Syncleus/roes-hardware/rf-analyzer/rf-analyzer.kicad_pcb

## KiCad design rf-analyzer/rf-analyzer.kicad_pcb (2020-09-04)

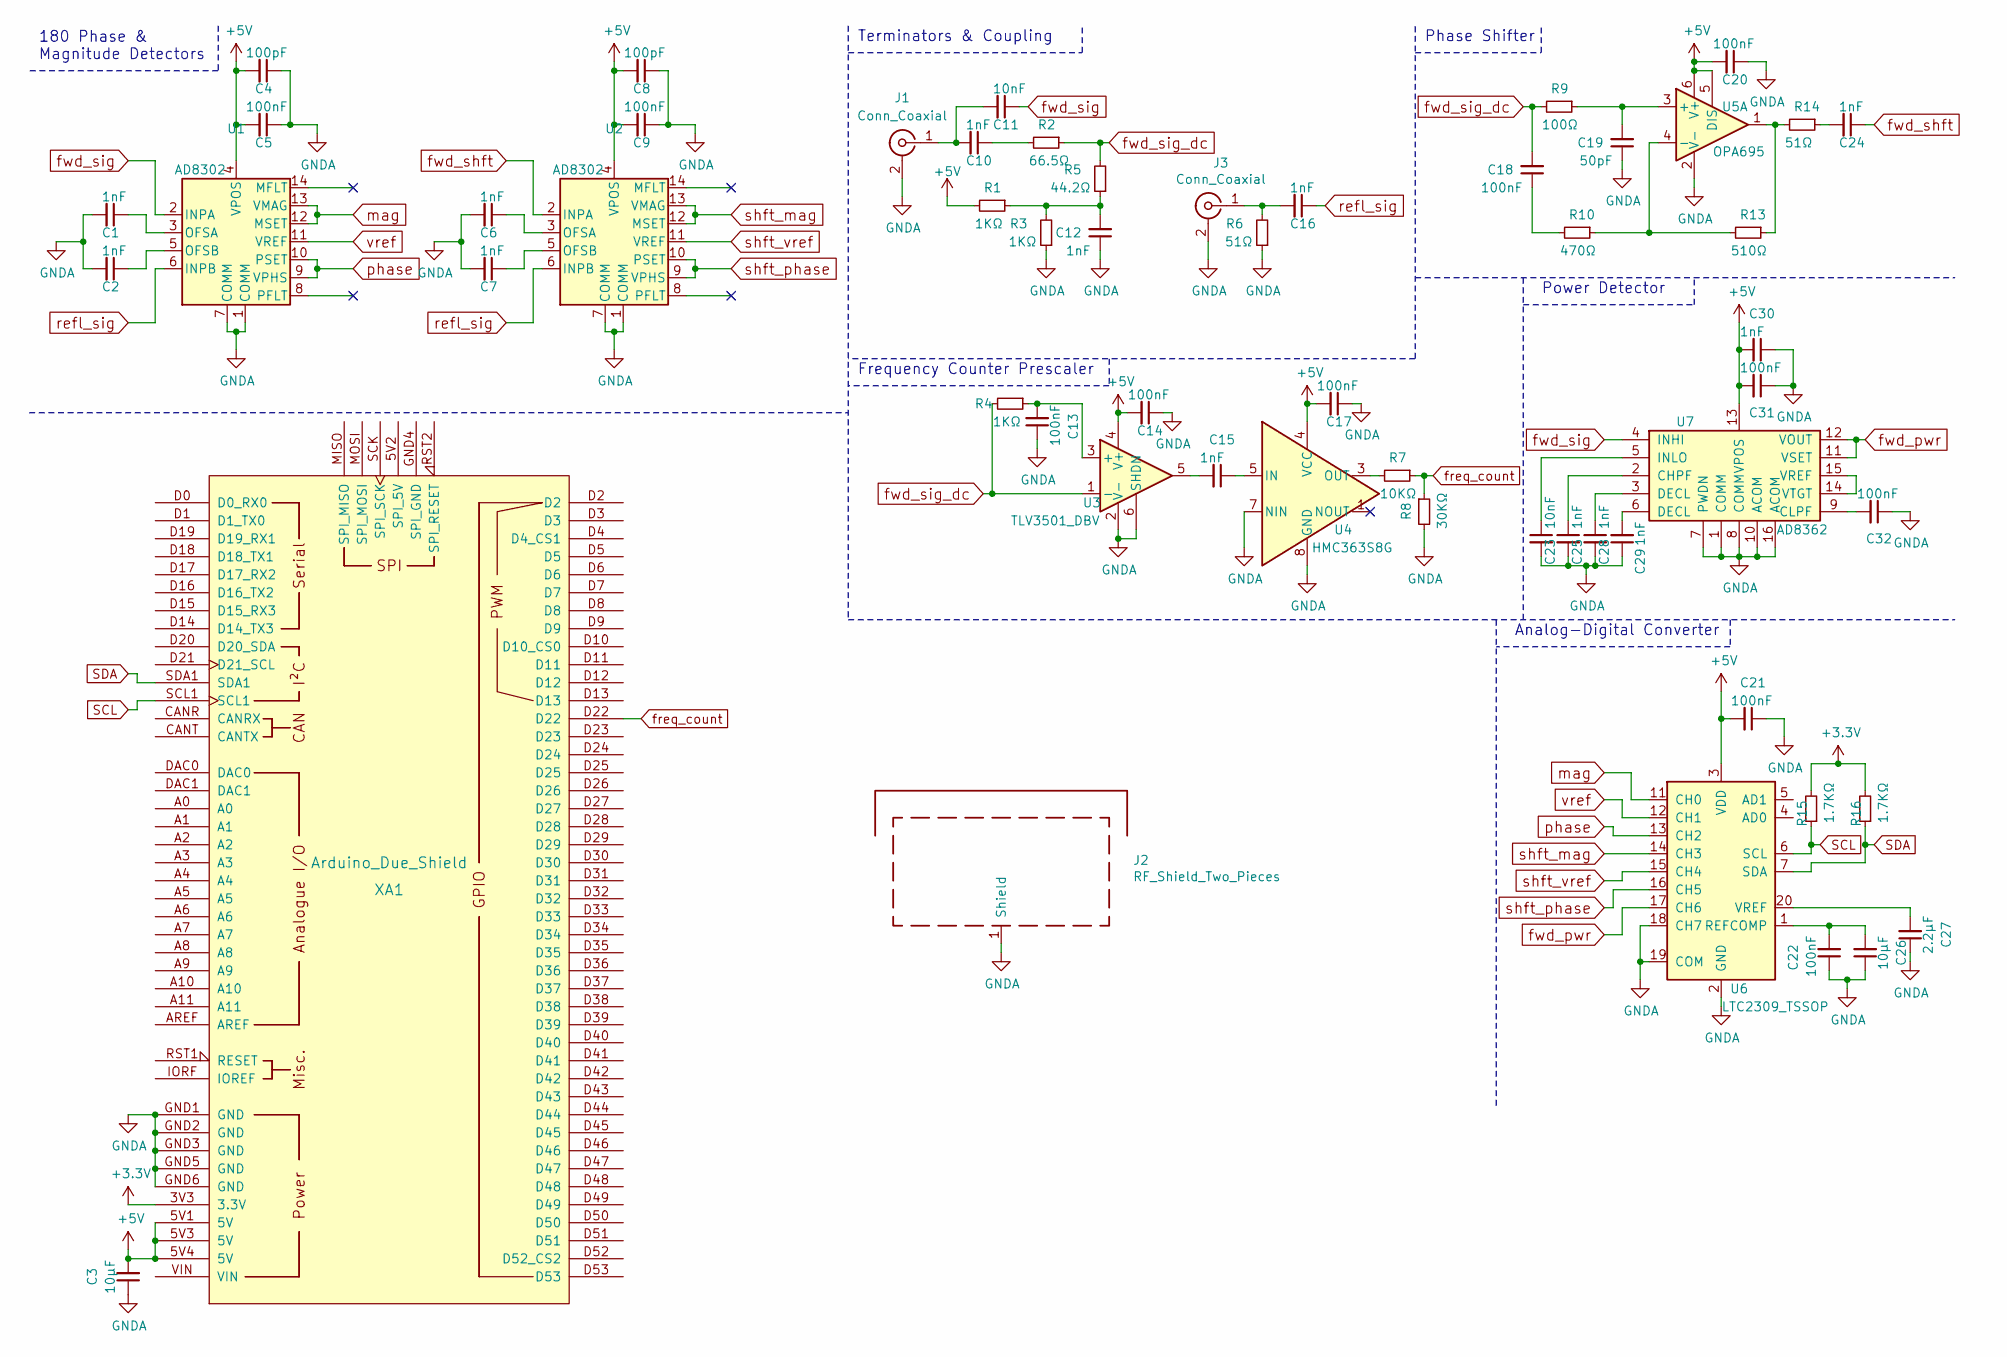
[picture p1: schematic rf-analyzer.sch, ROES VNA SWR Meter]

Parts:
C1, C2, C6, C7, C10, C12, C15, C16, C24, C25, C28, C29, C30: 1nF; C_0402_1005Metric
C3, C26: 10μF; C_0603_1608Metric
C4, C8: 100pF; C_0402_1005Metric
C5, C9, C13, C14, C17, C18, C20, C21, C22, C31, C32: 100nF; C_0402_1005Metric
C11, C23: 10nF; C_0402_1005Metric
C19: 50pF; C_0402_1005Metric
C27: 2.2μF; C_0402_1005Metric
J1, J3: Conn_Coaxial; SMA_Samtec_SMA-J-P-X-ST-EM1_EdgeMount
J2: RF_Shield_Two_Pieces; Laird_Technologies_BMI-S-230-F_50.8x38.1mm
R1, R3, R4: 1KΩ; C_0402_1005Metric
R2: 66.5Ω; C_0402_1005Metric
R5: 44.2Ω; C_0402_1005Metric
R6, R14: 51Ω; C_0402_1005Metric
R7: 10KΩ; C_0402_1005Metric
R8: 30KΩ; C_0402_1005Metric
R9: 100Ω; C_0402_1005Metric
R10: 470Ω; C_0402_1005Metric
R13: 510Ω; C_0402_1005Metric
R15, R16: 1.7KΩ; C_0402_1005Metric
U1, U2: AD8302; TSSOP-14_4.4x5mm_P0.65mm
U3: TLV3501_DBV; SOT-23-6
U4: HMC363S8G; SOIC-8_3.9x4.9mm_P1.27mm
U5: OPA695; SOT-23-6
U6: LTC2309_TSSOP; TSSOP-20_4.4x6.5mm_P0.65mm
U7: AD8362; TSSOP-16_4.4x5mm_P0.65mm
XA1: Arduino_Due_Shield

Connections:
+3V3: R15.2, R16.2, XA1.3V3 (3.3V)
+5V: C3.2, C4.2, C5.2, C8.2, C9.2, C14.2, C17.2, C20.2, C21.2, C30.2, C31.2, R1.2, U1.4 (VPOS), U2.4 (VPOS), U3.4 (V+), U4.4 (VCC), U5.5 (DIS), U5.6 (V+), U6.3 (VDD), U6.10 (VDD), U7.13 (VPOS), XA1.5V1 (5V), XA1.5V3 (5V), XA1.5V4 (5V)
GNDA: C1.2, C2.2, C3.1, C4.1, C5.1, C6.2, C7.2, C8.1, C9.1, C12.1, C13.1, C14.1, C17.1, C19.1, C20.1, C21.1, C22.1, C23.2, C25.2, C26.1, C27.1, C28.2, C29.1, C30.1, C31.1, C32.1, J1.2 (Ext), J2.1, J3.2 (Ext), R3.1, R6.1, R8.2, U1.1 (COMM), U1.7 (COMM), U2.1 (COMM), U2.7 (COMM), U3.2 (V-), U3.6 (SHDN), U4.7 (NIN), U4.8 (GND), U5.2 (V-), U6.2 (GND), U6.8 (GND), U6.9 (GND), U6.18 (CH7), U6.19 (COM), U7.1 (COMM), U7.7 (PWDN), U7.8 (COMM), U7.10 (ACOM), U7.16 (ACOM), XA1.GND1 (GND), XA1.GND2 (GND), XA1.GND3 (GND), XA1.GND5 (GND), XA1.GND6 (GND)
unnamed: C1.1, U1.3 (OFSA)
unnamed: C2.1, U1.5 (OFSB)
unnamed: C6.1, U2.3 (OFSA)
unnamed: C7.1, U2.5 (OFSB)
unnamed: C10.1, R2.2
unnamed: C10.2, C11.2, J1.1 (In)
unnamed: C12.2, R1.1, R3.2, R5.1
unnamed: C13.2, R4.1, U3.3 (+)
unnamed: C15.1, U4.5 (IN)
unnamed: C15.2, U3.5
unnamed: C16.2, J3.1 (In), R6.2
unnamed: C18.1, R10.2
unnamed: C19.2, R9.1, U5.3 (+)
unnamed: C22.2, C26.2, U6.1 (REFCOMP)
unnamed: C23.1, U7.5 (INLO)
unnamed: C24.2, R14.1
unnamed: C25.1, U7.2 (CHPF)
unnamed: C27.2, U6.20 (VREF)
unnamed: C28.1, U7.3 (DECL)
unnamed: C29.2, U7.6 (DECL)
unnamed: C32.2, U7.9 (CLPF)
unnamed: R7.2, U4.3 (OUT)
unnamed: R10.1, R13.2, U5.4 (-)
unnamed: R13.1, R14.2, U5.1
unnamed: U7.14 (VTGT), U7.15 (VREF)
SCL: R15.1, U6.6 (SCL), XA1.SCL1
SDA: R16.1, U6.7 (SDA), XA1.SDA1
freq_count: R7.1, R8.1, XA1.D22
fwd_pwr: U6.17 (CH6), U7.11 (VSET), U7.12 (VOUT)
fwd_shft: C24.1, U2.2 (INPA)
fwd_sig: C11.1, U1.2 (INPA), U7.4 (INHI)
fwd_sig_dc: C18.2, R2.1, R4.2, R5.2, R9.2, U3.1 (-)
mag: U1.12 (MSET), U1.13 (VMAG), U6.11 (CH0)
phase: U1.9 (VPHS), U1.10 (PSET), U6.13 (CH2)
refl_sig: C16.1, U1.6 (INPB), U2.6 (INPB)
shft_mag: U2.12 (MSET), U2.13 (VMAG), U6.14 (CH3)
shft_phase: U2.9 (VPHS), U2.10 (PSET), U6.16 (CH5)
shft_vref: U2.11 (VREF), U6.15 (CH4)
vref: U1.11 (VREF), U6.12 (CH1)

Notes on the sheet:
Phase Shifter
Power Detector
180 Phase & Magnitude Detectors
Terminators & Coupling
Analog-Digital Converter
Frequency Counter Prescaler

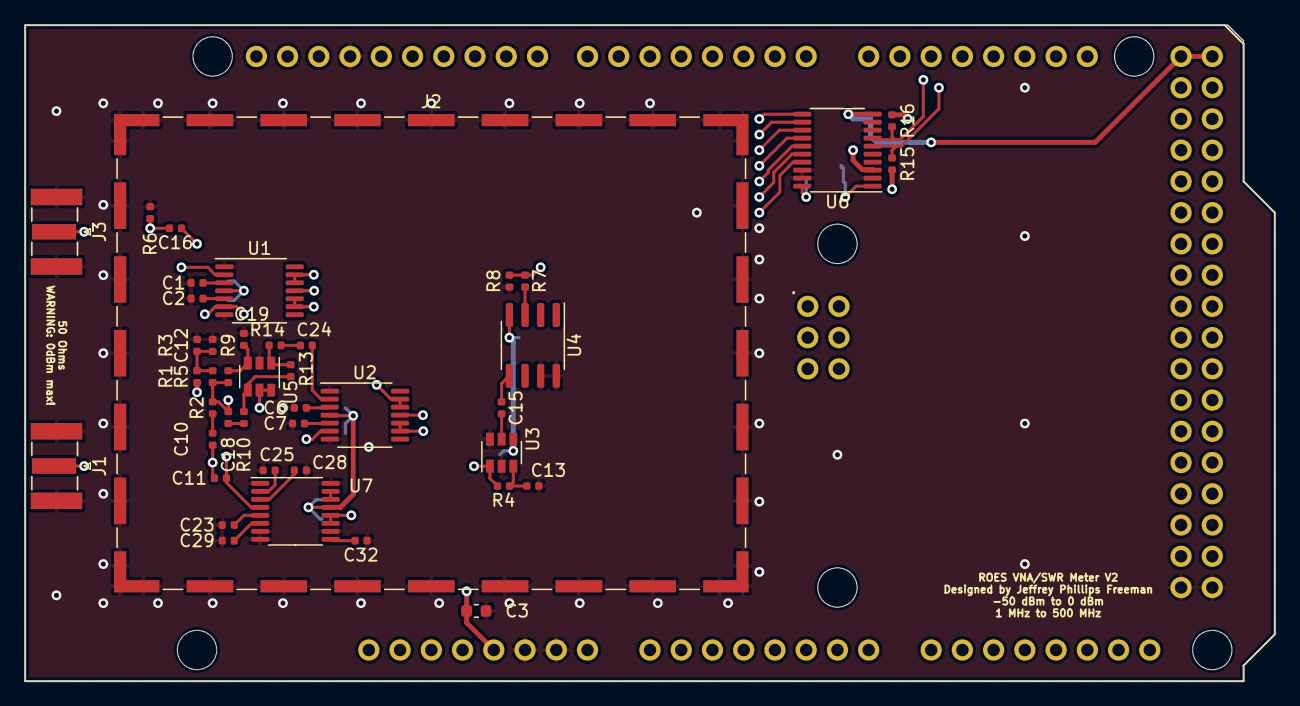
[picture p2: board rf-analyzer.kicad_pcb from above]

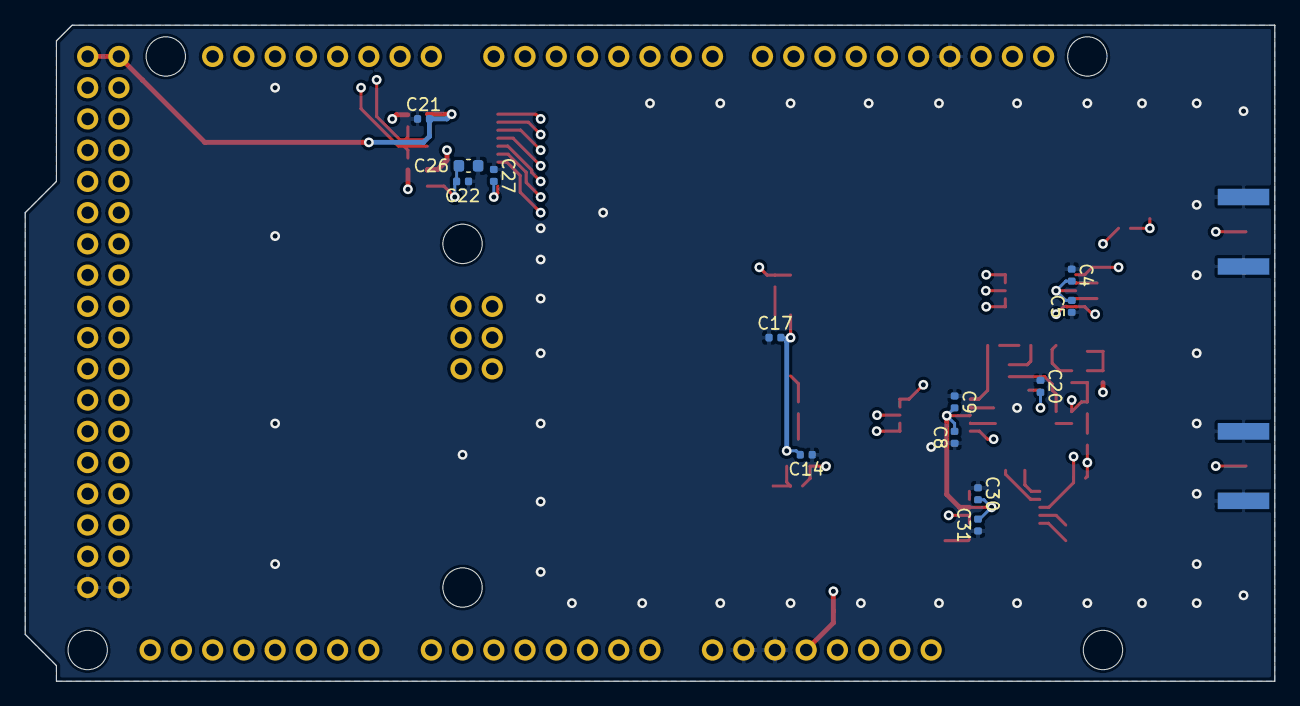
[picture p3: board rf-analyzer.kicad_pcb from below]

Board: 4 copper layers, 101.6 x 53.3 mm, 57 parts (13 on the bottom side), 42 nets.
