Syncleus/roes-hardware/(commit log)

2017-07-21 Initial working version of the ROES RF section, revision 0.1.
    [swr-meter.kicad_pcb, swr-meter.sch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]
2019-01-02 Updated resistors to larger sizes for more power.
2019-01-03 Got the old schematic imported
    [directional-coupler.kicad_pcb, directional-coupler.sch, rf-analyzer.kicad_pcb, rf-analyzer.sch, swr-meter-2019-01-02-20-50-29.sch, swr-meter-2019-01-02-20-54-48.sch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]
2019-01-03 Added and cleaned up DC schematic.
    [directional-coupler.sch]
2020-08-27 cleaned up schematic to use proper library symbols.
    [rf-analyzer.sch]
2020-08-27 Added Schematic metadata such as title.
    [rf-analyzer.sch]
2020-08-27 Moved a drawing line that was somehow misplaced.
    [rf-analyzer.sch]
2020-08-27 Removed LMX2322 from schematic.
    [rf-analyzer.sch]
2020-08-27 Updated power rails to be safer for the arduino Due.
    [rf-analyzer.sch]
2020-09-01 Revert "Updated power rails to be safer for the arduino Due."
    This reverts commit 4777d5e6577dfa59df44698bd1e5544e157ec2ab.
    [rf-analyzer.sch]
2020-09-01 Eliminated power splitters and attenuator.
    [rf-analyzer.sch]
2020-09-01 Cleaned up the ADC.
    [rf-analyzer.sch]
2020-09-01 Minor tweak to make phase shifter fit in the schematic.
    [rf-analyzer.sch]
2020-09-01 Associated correct footprint with Due shield in schematic.
    [rf-analyzer.sch]
2020-09-01 Fixed powerrails to use all pins on Due shield.
    [rf-analyzer.sch]
2020-09-01 Added frequency counter front-end.
    [rf-analyzer.sch]
2020-09-01 Made fall correction to power rails.
    [rf-analyzer.sch]
2020-09-01 Added frequency counter prescaler.
    [rf-analyzer.sch]
2020-09-01 Removed decoupling capacitor from prescaler.
    [rf-analyzer.sch]
2020-09-01 Added the decoupling caps in a central location allowing me to reduce the overall number of capacitors.
    [rf-analyzer.sch]
2020-09-01 Added shielding to schematic.
    [rf-analyzer.sch]
2020-09-01 Added a missing wire to a power rail.
    [rf-analyzer.sch]
2020-09-01 Added some missing bypass capacitors.
    [rf-analyzer.sch]
2020-09-01 Moved label so it didnt overlap.
    [rf-analyzer.sch]
2020-09-01 Removed the enumeration of the components, will re-add later5.
    [rf-analyzer.sch]
2020-09-02 Fixed bug in envelope detector that messed up DC decoupling.
    [rf-analyzer.sch]
2020-09-02 Reduced the number and value of the decoupling capacitors on the DC biasing section.
    [rf-analyzer.sch]
2020-09-02 moved tank on powerrail to new location.
    [rf-analyzer.sch]
2020-09-02 Replaced the zener with a voltage divder for better frequency response.
    [rf-analyzer.sch]
2020-09-02 moved around a power rail that was outside of the border.
    [rf-analyzer.sch]
2020-09-04 Updated footprints in schematic to match new minarturized design.
    [rf-analyzer.sch]
2020-09-04 Becgan populating the PCB.
    [rf-analyzer.kicad_pcb, rf-analyzer.sch]
2020-09-04 Upgraded power detection to use more accurate IC based true RMS.
    [rf-analyzer.sch]
2020-09-04 Added some additional design notes.
    [rf-analyzer.sch]
2020-09-04 Grounded a floating pin.
    [rf-analyzer.sch]
2020-09-04 Fixed incorrect ground point.
    [rf-analyzer.sch]
2020-09-04 Populated and routed PCB board.
    [rf-analyzer.kicad_pcb]
2020-09-04 Added some vias to ensure all layers are filled with a ground plane.
    [rf-analyzer.kicad_pcb]
2020-09-04 Added some silkscreen info.
    [rf-analyzer.kicad_pcb]
2020-09-04 Moved around SMA connectors to pass inspection.
    [rf-analyzer.kicad_pcb]
2020-09-04 Changed position of graphical lines on schematic.
    [rf-analyzer.sch]
2020-09-04 Final version of PCB.
    [rf-analyzer.kicad_pcb]
2020-09-04 Some minor fixes before printing V2 PCB.
    [rf-analyzer.kicad_pcb]
2020-09-05 Added some design notes to schematic.
    [rf-analyzer.sch]
2020-09-05 Adding cache lib for directional coupler.
    [swr-meter-2019-01-02-20-50-29.sch, swr-meter-2019-01-02-20-54-48.sch, swr-meter.kicad_pcb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]
2020-09-05 Moved one of the notes to be more visible.
    [rf-analyzer.sch]
2020-09-05 Minor adjustment to terminator resistor values.
    [rf-analyzer.sch]
